hjjayakrishnan/Robonauts/Firmware/README.MD

Final codes for the firmware.
Code is modular, abstracted and robust
