hjjayakrishnan/Robonauts/Project Outputs for Robonauts/Robonauts.xlsx

Description | Designator | Digikey Part No | Manufacturer | Manufacturer Part Number | Mouser Part No | Quantity | Value
CAP CER 10UF 10V X5R 0603 | C1, C5, C9, C24, C25, C31, C42 | 490-10474-1-ND | Murata Electronics North America | GRM188R61A106KE69D |  | 7 | 10uF
CAP CER 0.1UF 10V X7R 0603 | C2, C3, C6, C7, C10, C12, C14, C15, C18, C19, C20, C21, C32, C40, C41, C43, C44 | 399-1095-1-ND | KEMET | C0603C104K8RACTU |  | 17 | 0.1uF
CAP CER 22UF 6.3V X5R 0603 | C4, C8 | 490-7611-1-ND | Murata Electronics North America | GRM188R60J226MEA0D |  | 2 | 22uF
CAP CER 4.7UF 10V X5R 0603 | C11, C13 | 490-10477-1-ND | Murata Electronics North America | GRM188R61A475KE15D |  | 2 | 4.7uF
CAP CER 1UF 10V X7R 0603 | C16, C17, C26 | 1276-1946-1-ND | Samsung Electro-Mechanics America, Inc. | CL10B105KP8NNNC |  | 3 | 1uF
CAP CER 10000PF 50V X7R 0603 | C22, C23 | 311-1085-1-ND | Yageo | CC0603KRX7R9BB103 |  | 2 | 10nF
Multilayer Ceramic Capacitors MLCC - SMD/SMT 25V 7.5pF C0G 0201 .1pF Tol | C27, C28 |  | AVX | 02013A7R5BAT2A | 581-02013A7R5BAT2A | 2 | 7.5pF
CAP CER 18PF 250V NP0 0603 | C29, C30 | 712-1321-1-ND | Johanson Technology Inc. | 251R14S180GV4T |  | 2 | 18pF
CAP CER 47UF 6.3V X5R 0805 | C33, C39 | 490-13249-1-ND | Murata Electronics North America | GRM219R60J476ME44D |  | 2 | 47uF
CAP CER 0.1UF 16V X7R 0603 | C34 | 311-1088-1-ND | Yageo | CC0603KRX7R7BB104 |  | 1 | 0.1uF
CAP CER 22UF 6.3V X5R 1206 | C35 | 490-13247-1-ND | Murata Electronics North America | GRM188R60J476ME15D |  | 1 | 47uF
CAP CER 4.7UF 6.3V X7R 0603 | C36 | 1276-2087-1-ND | Samsung Electro-Mechanics America, Inc. | CL10B475KQ8NQNC |  | 1 | 4.7uF
CAP CER 100PF 50V X7R 0603 | C37 | 399-7824-1-ND | KEMET | C0603C101K5RACTU |  | 1 | 100pF
CAP CER 330PF 100V X7R 0603 | C38 | 1276-6658-1-ND | Samsung Electro-Mechanics America, Inc. | CL10B331KC8WPNC |  | 1 | 330pF
Default Diode | D1 | CD0603-S01575CT-ND | Bourns Inc. | CD0603-S01575 |  | 1
Typical INFRARED GaAs LED | D2 | 732-4981-1-ND | Wurth Electronics Inc. | 150060YS75000 |  | 1
 | H2 | 455-1719-ND | JST Sales America Inc. | S2B-PH-K-S(LF)(SN) |  | 1
CONN HDR 1.27MM SMD AU 10POS | H3 | 952-1389-ND | Harwin Inc. | M50-3600542 |  | 1
CONN RCPT USB MICRO AB SMD R/A | H4 | H125279CT-ND | Hirose Electric Co Ltd | ZX62-AB-5PA(31) |  | 1
Header, 2-Pin | H5 |  |  |  |  | 1
SENS IR PROXIMITY AMB LT 12LLP | IR1, IR2 | VCNL4010-GS08CT-ND | Vishay Semiconductor Opto Division | VCNL4010-GS08 |  | 2
Socket | J1, MTP1, MTP2, MTP3, MTP4, MTP5, TP1, TP2, TP3, TP4, TP5, TP6, TP7, TP8, TP9, TP10, TP11, TP12, TP13, TP16 |  |  |  |  | 20
FIXED IND 3.3UH 30MA 1.3 OHM SMD | L1 | 587-1584-1-ND | Taiyo Yuden | LK16083R3K-T |  | 1 | 3.3uH
FIXED IND 4.7UH 350MA 500 MOHM | L2 | 445-6390-1-ND | TDK Corporation | MLZ1608M4R7WT000 |  | 1 | 4.7uH
FERRITE BEAD 1 KOHM 0805 1LN | L3 | 490-1047-1-ND | Murata Electronics North America | BLM21BD102SN1D |  | 1 | 1kohm @ 100 MHz
ARM Microcontrollers - MCU 256k Flash 32k RAM USB 8x34 LCD AES | LG1 |  | Silicon Labs | EFM32LG980F256G-E-QFP100 | 634-EFM32LG980F256GE | 1
Bluetooth / 802.15.1 Modules Chip Antenna UFL connector MU-T | M2 |  | Microchip Technology/Atmel | ATSAMB11-MR210CA | 556-ATSAMB11-MR210CA | 1
IC I2C SW 8CH W/RESET 24TSSOP | Mul1 | 296-34905-1-ND | Texas Instruments | TCA9548APWR |  | 1
IC SWITCH POWER MANAGER 20-QFN | P1 | TC4160EUDC#PBF-ND | Linear Technology | LTC4160EUDC#PBF |  | 1
IC REG BOOST ADJ 2A 8SOIC | P2 | LT1308IS8#PBF-ND | Linear Technology | LT1308IS8#PBF |  | 1
V_REG MIC5219Standard 3.3V and 5V 500mA LDO voltage regulator in SOT-23 layout. Micrel part MIC5219. BP (by-pass) pinMIC5219-2.8YM5-TR | P3 | 576-2762-1-ND | Microchip Technology | MIC5219-2.8YM5-TR |  | 1
Header, 6-Pin | PH1 |  |  |  |  | 1
MOSFET N-CH 20V 3A 6-TSOP | Q2, Q3 | SI3442BDV-T1-E3CT-ND | Vishay Siliconix | SI3442BDV-T1-E3 |  | 2
RES SMD 4.7K OHM 5% 1/10W 0603 | R1, R2, R3, R4, R5, R6, R7, R8, R9, R10 | 311-4.7KGRCT-ND | Yageo | RC0603JR-074K7L |  | 10 | 4.7K
RES SMD 10K OHM 5% 1/16W 0402 | R11 | 311-10KJRCT-ND | Yageo | RC0402JR-0710KL |  | 1 | 10K
RES SMD 10 OHM 1% 1/10W 0603 | R12, R13, R26 | 311-10.0HRCT-ND | Yageo | RC0603FR-0710RL |  | 3 | 10
RES SMD 4.7K OHM 5% 1/10W 0603 | R14, R15 | 311-4.7KGRCT-ND | Yageo | RC0603JR-074K7L |  | 2 | 4.7K
RES SMD 2.2K OHM 1% 1/16W 0402 | R16 | 311-2.20KLRCT-ND | Yageo | RC0402FR-072K2L |  | 1 | 2.2K
RES SMD 10K OHM 1% 1/10W 0603 | R17, R22, R25 | 311-10.0KHRCT-ND | Yageo | RC0603FR-0710KL |  | 3 | 10K, 10K, 3K
RES SMD 6.2K OHM 1% 1/10W 0603 | R18 | 311-6.20KHRCT-ND | Yageo | RC0603FR-076K2L |  | 1 | 6.2K
RES SMD 1K OHM 1% 1/10W 0603 | R19 | 311-1.00KHRCT-ND | Yageo | RC0603FR-071KL |  | 1 | 1K
RES SMD 3.01K OHM 1% 1/10W 0603 | R20 | 311-3.01KHRCT-ND | Yageo | RC0603FR-073K01L |  | 1 | 3.01K
RES SMD 47K OHM 1% 1/10W 0603 | R21, R34 | 311-47.0KHRCT-ND | Yageo | RC0603FR-0747KL |  | 2 | 47K, 0
RES SMD 35.7K OHM 1% 1/10W 0603 | R23 | 311-35.7KHRCT-ND | Yageo | RC0603FR-0735K7L |  | 1 | 35.7K
RES SMD 11.3K OHM 1% 1/10W 0603 | R24 | 311-11.3KHRCT-ND | Yageo | RC0603FR-0711K3L |  | 1 | 11.3K
SWITCH TACTILE SPST-NO 0.05A 15V | S1 | EG4621CT-ND | E-Switch | TL3315NF160Q |  | 1
IC HI-SIDE SW CTRL SNGL TSOT23-5 | S2 | LTC1981ES5#TRMPBFCT-ND | Linear Technology | LTC1981ES5#TRMPBF |  | 1
IC 4BIT NON-INV TRANSLTR 14-QFN | T1 | 296-20698-1-ND | Texas Instruments | TXS0104ERGYR |  | 1
MOD TIME-OF-FLIGHT 3IN1 12LGA | TOF | 497-14702-1-ND | STMicroelectronics | VL6180XV0NR/1 |  | 1
ACCELEROMETER 2-8G I2C 16QFN | U2 | MMA8452QR1CT-ND | NXP USA Inc. | MMA8452QR1 |  | 1
Crystal Oscillator | Y1 |  |  |  |  | 1
CRYSTAL 32.7680KHZ 12.5PF SMD | Y2, Y3 | 535-12051-1-ND | Abracon LLC | AB26TRQ-32.768KHZ-T |  | 2 | [NoValue], 32.768kHz
