hjjayakrishnan/Robonauts/Robonauts.pdf

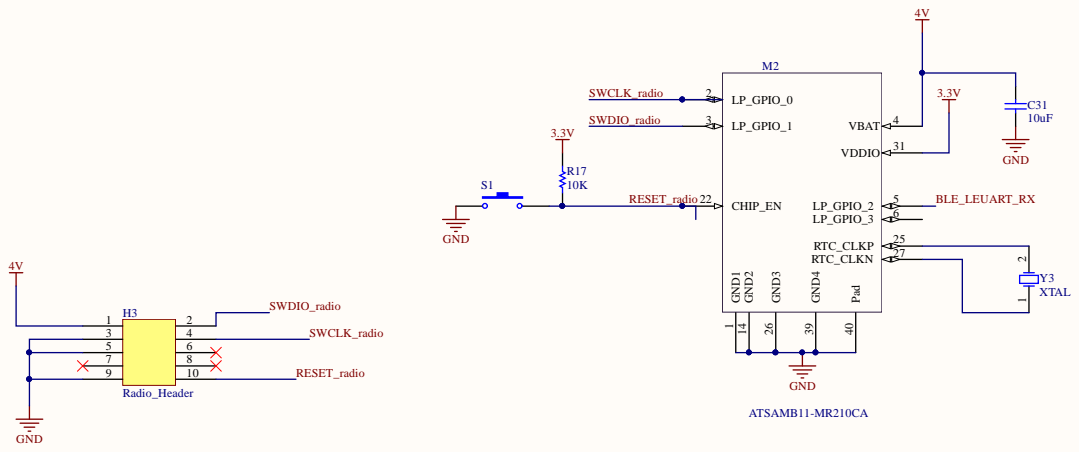
[picture p1: page 1]

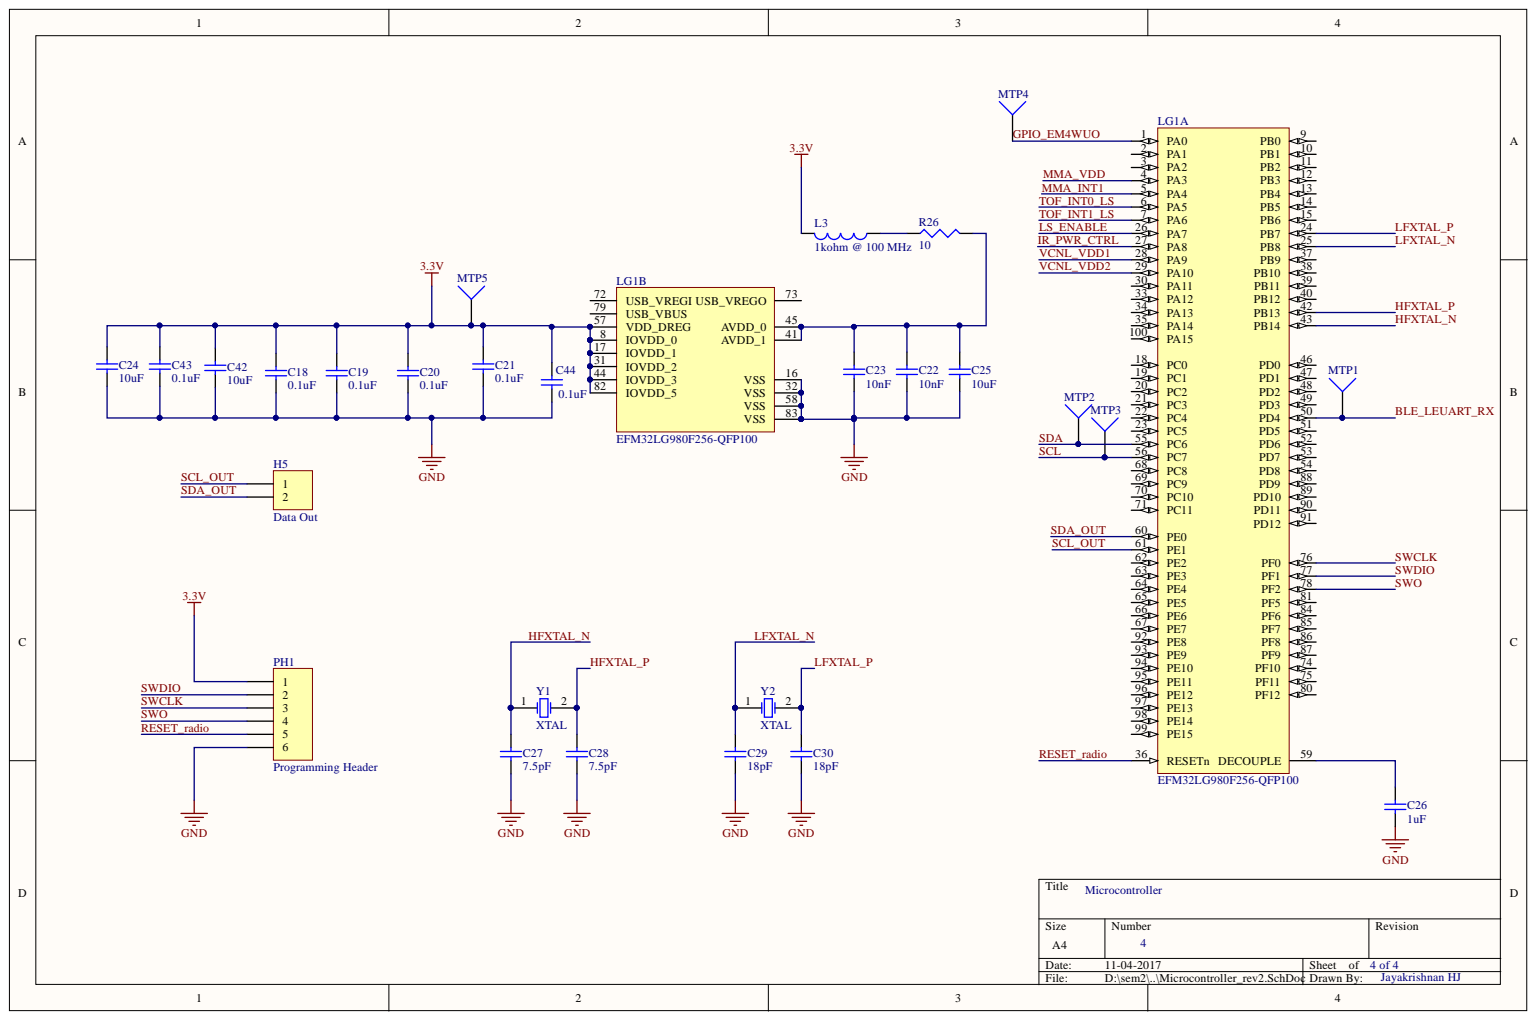
[picture p2: page 2]

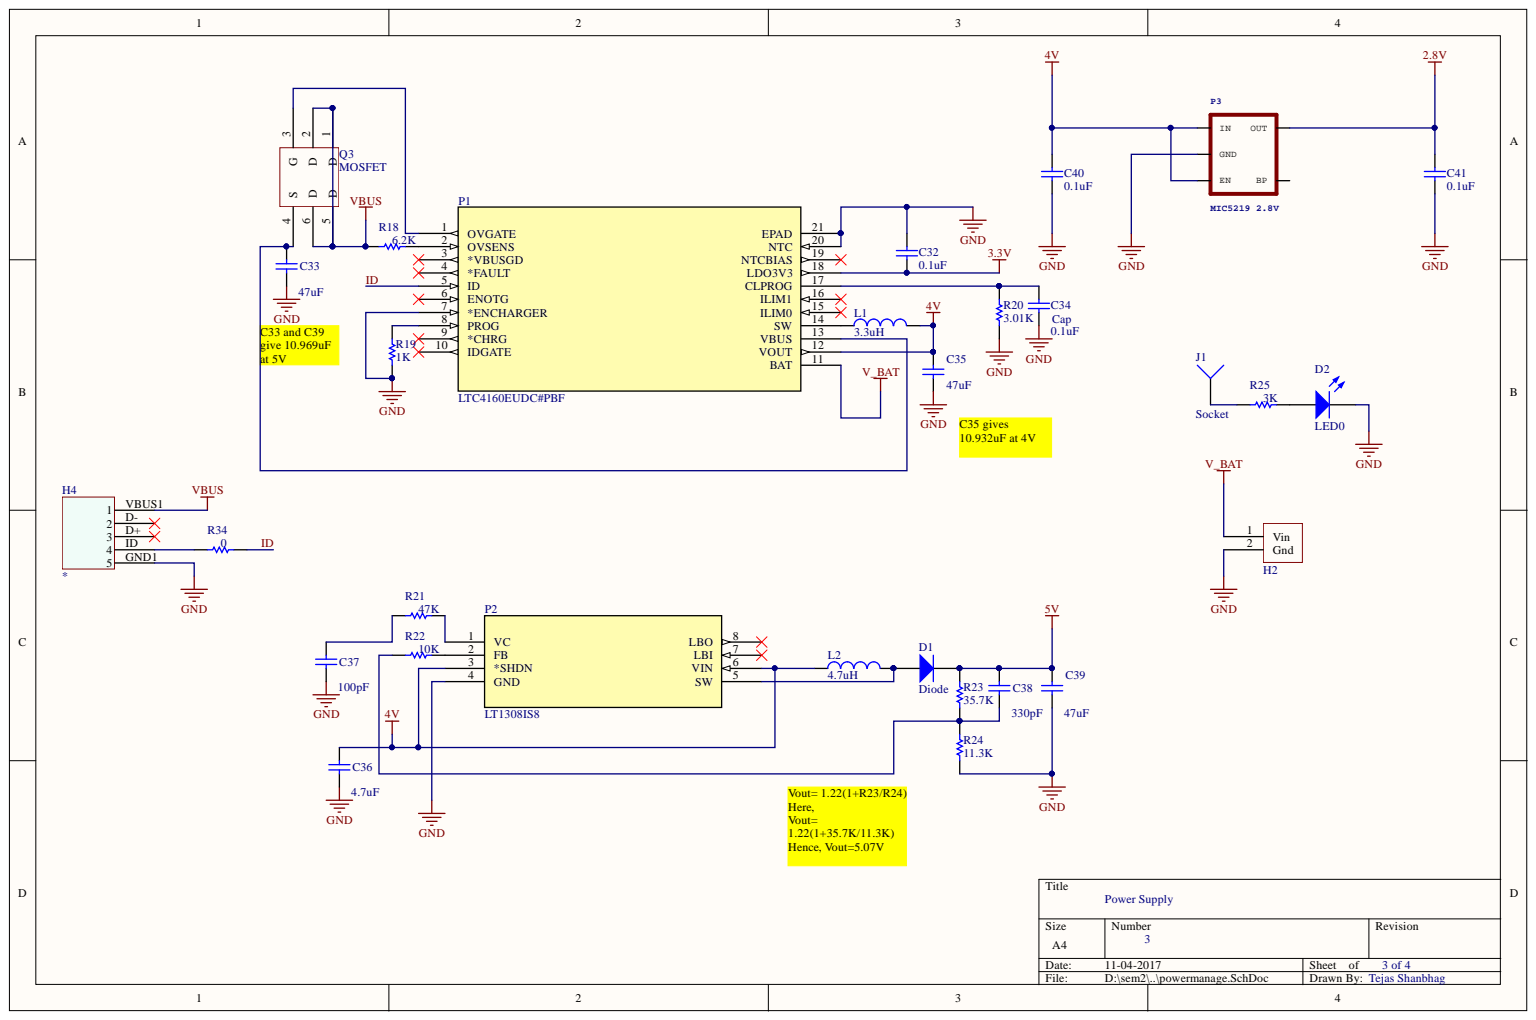
[picture p3: page 3]

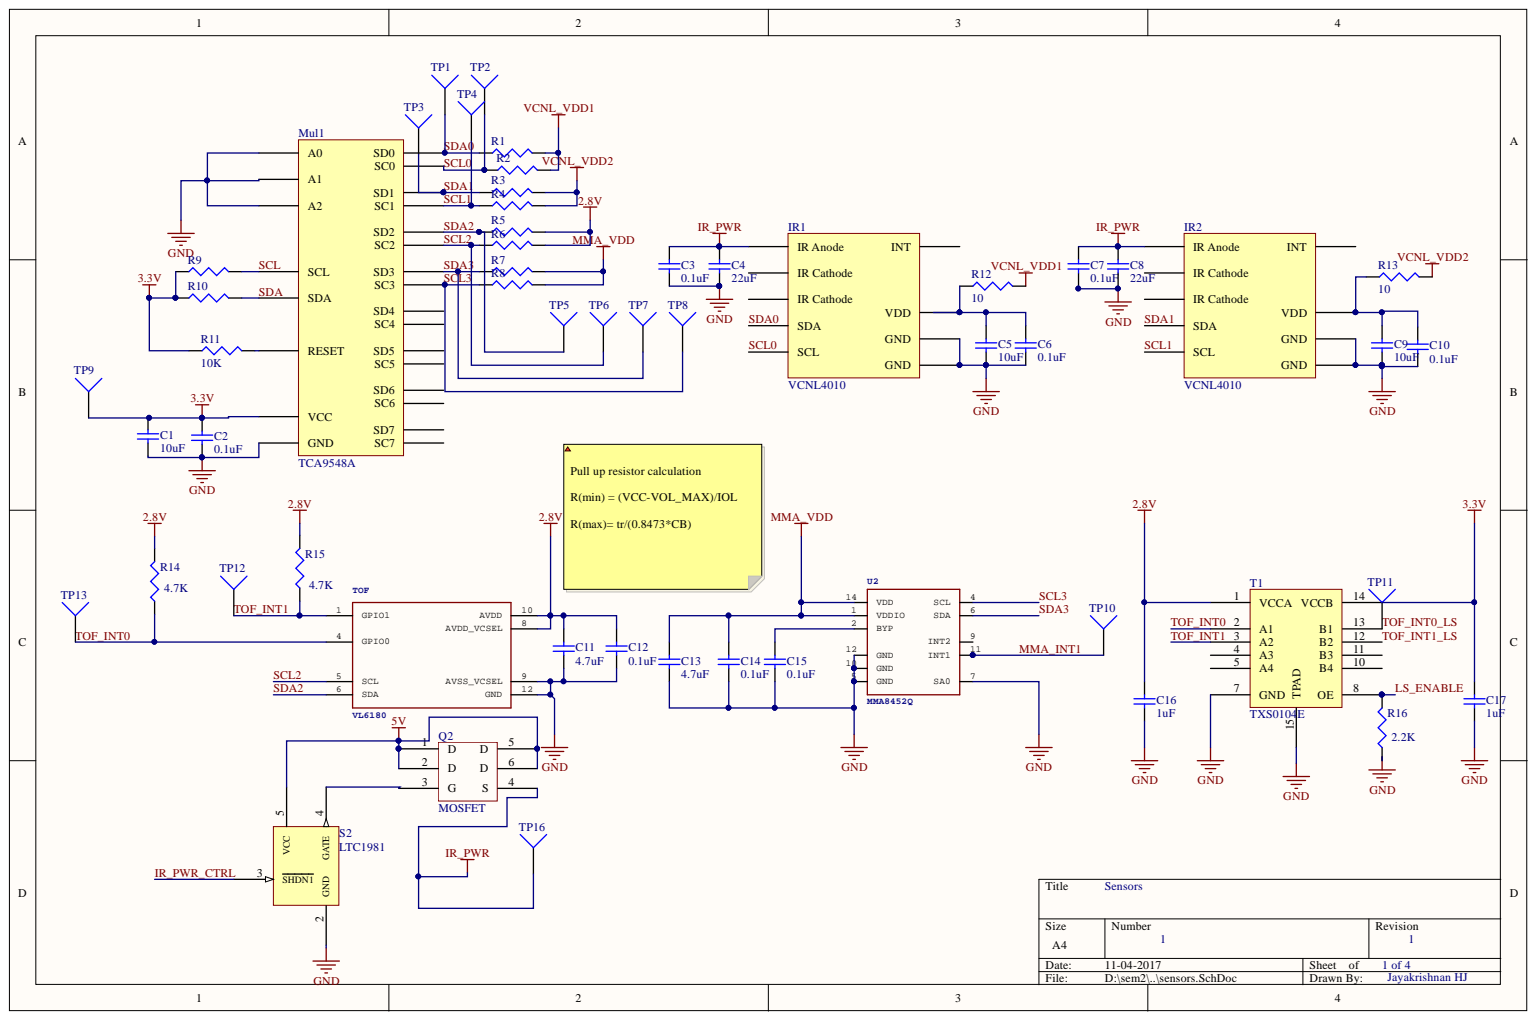
[picture p4: page 4]

Pull up resistor calculation

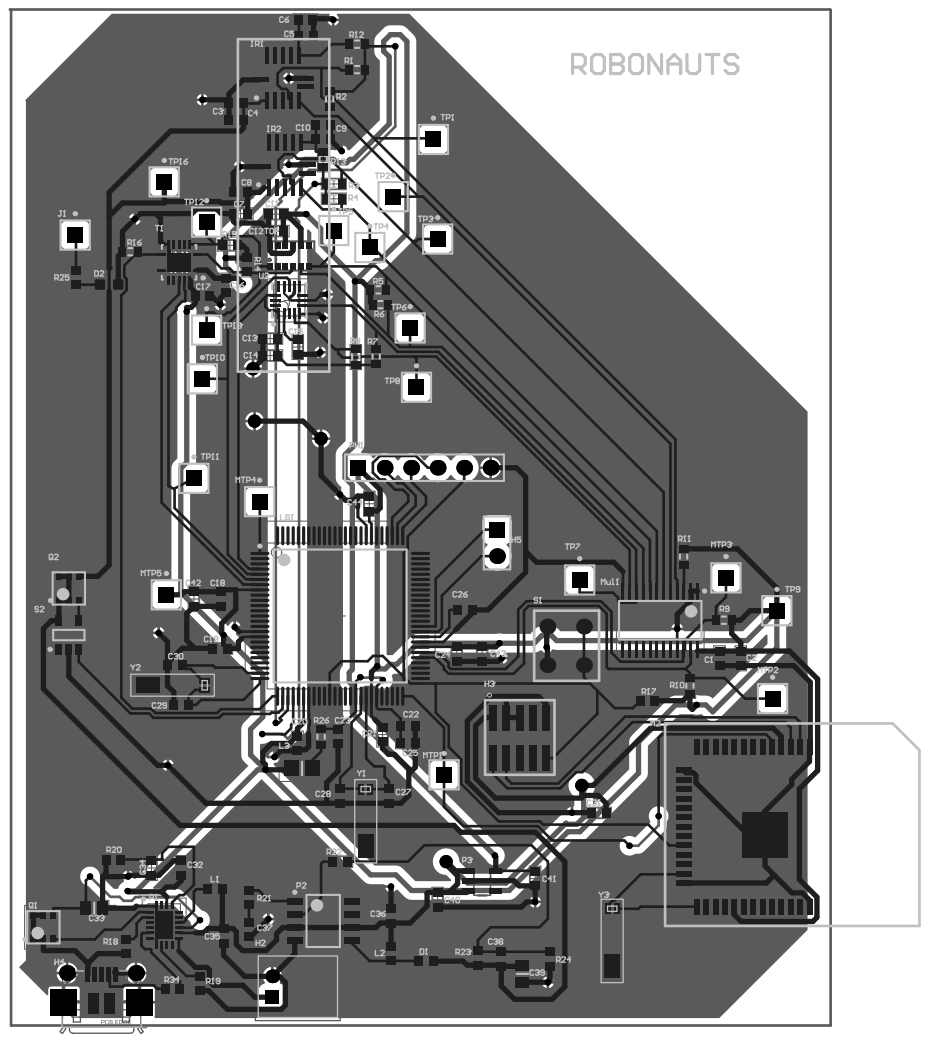
[picture p5: page 5]

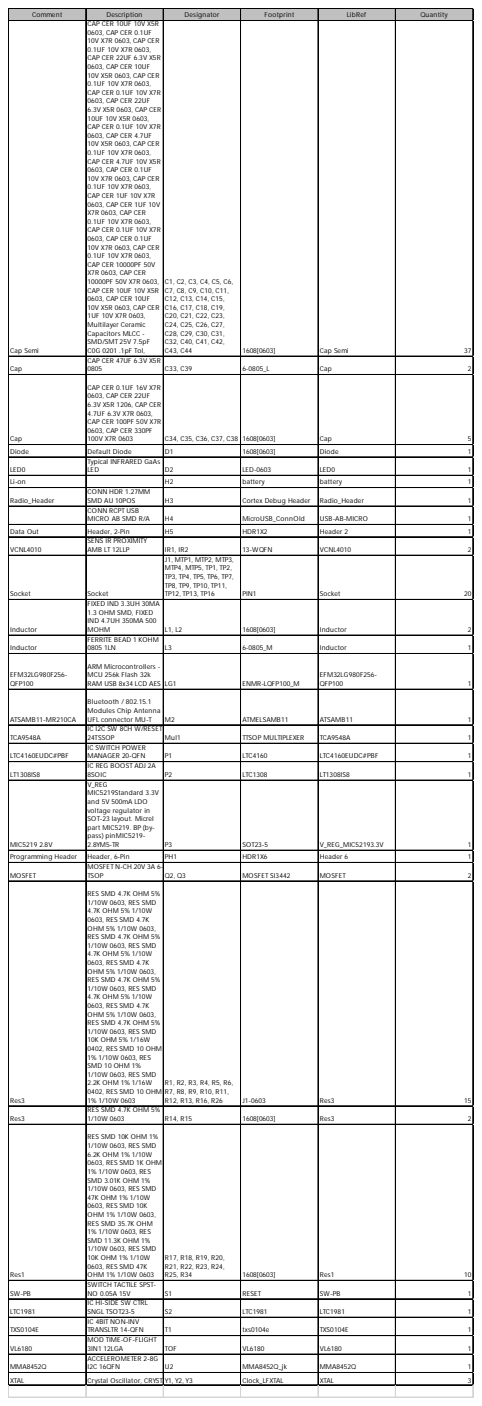
[picture p6: page 6]

Cap | CAP CER 47UF 6.3V X5R 0805 | C33, C39 | 6-0805_L | Cap | 2

Cap | CAP CER 0.1UF 16V X7R 0603, CAP CER 22UF 6.3V X5R 1206, CAP CER 4.7UF 6.3V X7R 0603, CAP CER 100PF 50V X7R 0603, CAP CER 330PF 100V X7R 0603 | C34, C35, C36, C37, C38 | 1608[0603] | Cap | 5

Diode | Default Diode | D1 | 1608[0603] | Diode | 1
LED0 | Typical INFRARED GaAs LED | D2 | LED-0603 | LED0 | 1

Li-on | | H2 | battery | battery | 1
Radio_Header | CONN HDR 1.27MM SMD AU 10POS | H3 | Cortex Debug Header | Radio_Header | 1

CONN RCPT USB MICRO AB SMD R/A | H4 | MicroUSB_ConnOld | USB-AB-MICRO | 1

Data Out | Header, 2-Pin | H5 | HDR1X2 | Header 2 | 1
VCNL4010 | SENS IR PROXIMITY AMB LT 12LLP | IR1, IR2 | 13-WQFN | VCNL4010 | 2

Socket | Socket | J1, MTP1, MTP2, MTP3, MTP4, MTP5, TP1, TP2, TP3, TP4, TP5, TP6, TP7, TP8, TP9, TP10, TP11, TP12, TP13, TP16 | PIN1 | Socket | 20

Inductor | FIXED IND 3.3UH 30MA 1.3 OHM SMD, FIXED IND 4.7UH 350MA 500 MOHM | L1, L2 | 1608[0603] | Inductor | 2

Inductor | FERRITE BEAD 1 KOHM 0805 1LN | L3 | 6-0805_M | Inductor | 1

EFM32LG980F256-QFP100 | ARM Microcontrollers -MCU 256k Flash 32k RAM USB 8x34 LCD AES | LG1 | ENMR-LQFP100_M | EFM32LG980F256-QFP100 | 1

ATSAMB11-MR210CA | Bluetooth / 802.15.1 Modules Chip Antenna UFL connector MU-T | M2 | ATMELSAMB11 | ATSAMB11 | 1

TCA9548A | IC I2C SW 8CH W/RESET 24TSSOP | Mul1 | TTSOP MULTIPLEXER | TCA9548A | 1

LTC4160EUDC#PBF | IC SWITCH POWER MANAGER 20-QFN | P1 | LTC4160 | LTC4160EUDC#PBF | 1

LT1308IS8 | IC REG BOOST ADJ 2A 8SOIC | P2 | LTC1308 | LT1308IS8 | 1

MIC5219 2.8V | V_REG MIC5219Standard 3.3V and 5V 500mA LDO voltage regulator in SOT-23 layout. Micrel part MIC5219. BP (by-pass) pinMIC5219-2.8YM5-TR | P3 | SOT23-5 | V_REG_MIC52193.3V | 1

Programming Header | Header, 6-Pin | PH1 | HDR1X6 | Header 6 | 1
MOSFET | MOSFET N-CH 20V 3A 6-TSOP | Q2, Q3 | MOSFET SI3442 | MOSFET | 2

Res3 | RES SMD 4.7K OHM 5% 1/10W 0603, RES SMD 4.7K OHM 5% 1/10W 0603, RES SMD 4.7K OHM 5% 1/10W 0603, RES SMD 4.7K OHM 5% 1/10W 0603, RES SMD 4.7K OHM 5% 1/10W 0603, RES SMD 4.7K OHM 5% 1/10W 0603, RES SMD 4.7K OHM 5% 1/10W 0603, RES SMD 4.7K OHM 5% 1/10W 0603, RES SMD 4.7K OHM 5% 1/10W 0603, RES SMD 4.7K OHM 5% 1/10W 0603, RES SMD 10K OHM 5% 1/16W 0402, RES SMD 10 OHM 1% 1/10W 0603, RES SMD 10 OHM 1% 1/10W 0603, RES SMD 2.2K OHM 1% 1/16W 0402, RES SMD 10 OHM 1% 1/10W 0603 | R1, R2, R3, R4, R5, R6, R7, R8, R9, R10, R11, R12, R13, R16, R26 | J1-0603 | Res3 | 15

Res3 | RES SMD 4.7K OHM 5% 1/10W 0603 | R14, R15 | 1608[0603] | Res3 | 2

Res1 | RES SMD 10K OHM 1% 1/10W 0603, RES SMD 6.2K OHM 1% 1/10W 0603, RES SMD 1K OHM 1% 1/10W 0603, RES SMD 3.01K OHM 1% 1/10W 0603, RES SMD 47K OHM 1% 1/10W 0603, RES SMD 10K OHM 1% 1/10W 0603, RES SMD 35.7K OHM 1% 1/10W 0603, RES SMD 11.3K OHM 1% 1/10W 0603, RES SMD 10K OHM 1% 1/10W 0603, RES SMD 47K OHM 1% 1/10W 0603 | R17, R18, R19, R20, R21, R22, R23, R24, R25, R34 | 1608[0603] | Res1 | 10

SW-PB | SWITCH TACTILE SPST-NO 0.05A 15V | S1 | RESET | SW-PB | 1

LTC1981 | IC HI-SIDE SW CTRL SNGL TSOT23-5 | S2 | LTC1981 | LTC1981 | 1

TXS0104E | IC 4BIT NON-INV TRANSLTR 14-QFN | T1 | txs0104e | TXS0104E | 1

VL6180 | MOD TIME-OF-FLIGHT 3IN1 12LGA | TOF | VL6180 | VL6180 | 1

MMA8452Q | ACCELEROMETER 2-8G I2C 16QFN | U2 | MMA8452Q_jk | MMA8452Q | 1

XTAL | Crystal Oscillator, CRYSTALY1, Y2, Y3 | | Clo ck_LFXTAL | XTAL | 3
