hjjayakrishnan/Robonauts/(list of files, drawings)

Other design files:
ATSAMB11.SchDoc
Board1.PcbDoc
Microcontroller.SchDoc
Microcontroller_rev2.SchDoc
PCB1_Tejas.PcbDoc
PcbLib1.PcbLib
powermanage.SchDoc
Robonauts.PrjPcb
sensors.SchDoc
