hjjayakrishnan/Robonauts/(commit log)

2017-03-15 Edits made after first schematic review
    [Microcontroller.SchDoc, Microcontroller_rev2.SchDoc, Robonauts.PrjPcb, sensors.SchDoc]
2017-03-15 updated vcc to 3.3V
    [sensors.SchDoc]
2017-03-18 updated after 1st review
    [ATSAMB11.SchDoc, powermanage.SchDoc]
2017-03-19 after local review
    [ATSAMB11.SchDoc, Microcontroller_rev2.SchDoc, powermanage.SchDoc, sensors.SchDoc]
2017-03-20 added reset s/w for uC and testpoints
    [Microcontroller_rev2.SchDoc, sensors.SchDoc]
2017-03-20 library added
    [acc.PcbLib]
2017-03-22 added some part information and removed excess components
    [ATSAMB11.SchDoc, Microcontroller_rev2.SchDoc, PcbLib1.PcbLib, Robonauts.PrjPcb, powermanage.SchDoc, sensors.SchDoc]
2017-03-22 changes to capacitor des and description
    [ATSAMB11.SchDoc, Microcontroller_rev2.SchDoc, Robonauts.PrjPcb, powermanage.SchDoc, sensors.SchDoc]
2017-03-22 added inductor description
    [Microcontroller_rev2.SchDoc, powermanage.SchDoc]
2017-03-25 removed compile errors
    [Microcontroller_rev2.SchDoc, Robonauts.PrjPcb, powermanage.SchDoc, sensors.SchDoc]
2017-03-26 added corresponding footprints
    [Microcontroller_rev2.SchDoc, powermanage.SchDoc, sensors.SchDoc]
2017-03-27 Rectified all inconsistencies and prepared for first layout
    [ATSAMB11.SchDoc, Board1.PcbDoc, Robonauts.PrjPcb, powermanage.SchDoc, sensors.SchDoc]
2017-03-27 added power components on the PCB
    [Board1.PcbDoc, Robonauts.PrjPcb]
2017-03-28 added the schematics and footprint for diode and battery. Also changed MURATA capacitor
    [Microcontroller_rev2.SchDoc, Robonauts.PrjPcb, powermanage.SchDoc]
2017-03-28 changed diode
    [powermanage.SchDoc]
2017-03-29 done with the power part pls verify
    [PCB1_Tejas.PcbDoc]
2017-03-29 added decoupling cap and made corrections for MCU
    [Microcontroller_rev2.SchDoc, Robonauts.PrjPcb]
2017-03-30 added footprint and designators for ferrite bead and added power to MCU layout
    [Microcontroller_rev2.SchDoc, PCB1_Tejas.PcbDoc, powermanage.SchDoc]
2017-04-01 made changes to C4 and C8
    [sensors.SchDoc]
2017-04-02 made changes for layout and almost final layout
    [ATSAMB11.SchDoc, Microcontroller_rev2.SchDoc, PCB1_Tejas.PcbDoc, sensors.SchDoc]
2017-04-02 reset switch changed with footprint
    [ATSAMB11.SchDoc, PCB1_Tejas.PcbDoc, Robonauts.PrjPcb]
2017-04-04 final component addition except samb11 header
    [ATSAMB11.SchDoc, Microcontroller_rev2.SchDoc, Robonauts.PrjPcb, powermanage.SchDoc, sensors.SchDoc]
2017-04-04 verified connection
    [sensors.SchDoc]
2017-04-04 ground pour
    [PCB1_Tejas.PcbDoc]
2017-04-04 all connections except one
    [Microcontroller_rev2.SchDoc, PCB1_Tejas.PcbDoc]
2017-04-05 changed with footprints
    [ATSAMB11.SchDoc, Microcontroller_rev2.SchDoc, PCB1_Tejas.PcbDoc, Robonauts.PrjPcb, powermanage.SchDoc, sensors.SchDoc]
2017-04-05 resolved unrouted nets and clearance
    [Microcontroller_rev2.SchDoc, Robonauts.PrjPcb, powermanage.SchDoc, sensors.SchDoc]
2017-04-05 added overlay for sensors
    [PCB1_Tejas.PcbDoc]
2017-04-06 changed USB footprint and added for osc
    [ATSAMB11.SchDoc, Microcontroller_rev2.SchDoc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]
2017-04-06 before sharat's changes
    [PCB1_Tejas.PcbDoc, powermanage.SchDoc]
2017-04-06 final layout with designators assigned
    [PCB1_Tejas.PcbDoc, Robonauts.PrjPcb]
2017-04-06 added designators
    [powermanage.SchDoc]
2017-04-06 added descriptors for all sheets except powermanage
    [ATSAMB11.SchDoc, Microcontroller_rev2.SchDoc, Robonauts.PrjPcb, sensors.SchDoc]
2017-04-06 Added description for LG header
    [Microcontroller_rev2.SchDoc]
2017-04-06 final PCB and some descriptions missed
    [ATSAMB11.SchDoc, Microcontroller_rev2.SchDoc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]
2017-04-12 final touch up and bom
    [ATSAMB11.SchDoc, Microcontroller_rev2.SchDoc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]
2017-04-12 final PCB and gerber
    [PCB1_Tejas.DRL, PCB1_Tejas.GBL, PCB1_Tejas.GBO, PCB1_Tejas.GBP, PCB1_Tejas.GBS, PCB1_Tejas.GTL, PCB1_Tejas.GTO, PCB1_Tejas.GTP]
2017-04-12 added sheet number
    [ATSAMB11.SchDoc, Microcontroller_rev2.SchDoc, PCB1_Tejas.PcbDoc, Robonauts.PrjPcb, powermanage.SchDoc, sensors.SchDoc]
